devttys1/usb-pd-240w/docs/img/board-routed-dark.gif

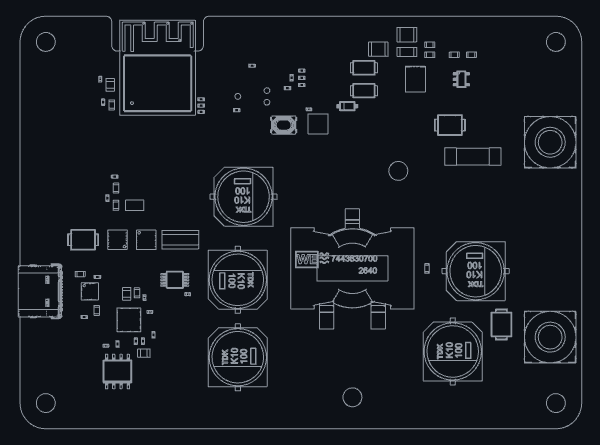
docs/img/board-routed-dark.gif
