devttys1/usb-pd-240w/(list of files, drawings)

Other design files:
00_Top.SchDoc
01_BatteryProtection.SchDoc
02_PowerStage.SchDoc
03_USBC_PD.SchDoc
04_Monitor_MCU.SchDoc
05_AuxPower.SchDoc
USB-PD-240W-PCB.PcbDoc
usb-pd-240w.PrjPcb
