devttys1/usb-pd-240w/(commit log)

2026-09-30 USB-PD 240 W bidirectional converter (work in progress)
    Altium project for a 240 W bidirectional battery to USB-C PD 3.2 EPR
    converter: TI BQ25756 four-switch buck-boost with EPC2302 GaN, TPS26750A
    dual-role PD controller, LTC4368-1 battery protection and ESP32-C6 /
    ESPHome monitoring. README with a top/bottom line drawing of the current
    3D model, the block diagram, calculated efficiency and 240 W losses, and
    the top and bottom placement drawings.
    Claude-Session: https://claude.ai/code/session_01DtjmeW5DAmtiNRfaUeAi7L
    [00_Top.SchDoc, 01_BatteryProtection.SchDoc, 02_PowerStage.SchDoc, 03_USBC_PD.SchDoc, 04_Monitor_MCU.SchDoc, 05_AuxPower.SchDoc, USB-PD-240W-PCB.PcbDoc, usb-pd-240w.PrjPcb]
2026-10-28 Schematic complete, PCB placed and routed with a clean DRC
    Every sheet now carries its support parts (pin straps, dividers,
    decoupling), plus an addressable RGB status LED, a BOOT button and a
    TC2030 serial/boot header on the ESP32. The 6-layer PCB is placed and
    hand routed: copper pours for the 20 A paths with via stitching, a
    single four-terminal circuit-breaker shunt, and the silkscreen tidied;
    Altium's design-rule check passes. The ESPHome configuration matches
    the schematic (RGB LED on GPIO8, third NTC on the battery FETs). README:
    status, specifications, the top/bottom drawing of the current 3D model
    and the placement drawings brought up to date.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
    [00_Top.SchDoc, 01_BatteryProtection.SchDoc, 02_PowerStage.SchDoc, 03_USBC_PD.SchDoc, 04_Monitor_MCU.SchDoc, 05_AuxPower.SchDoc, USB-PD-240W-PCB.PcbDoc, usb-pd-240w.PrjPcb]
